ujkhm/micro-generator-test-machine/BOM/Master BOM.XLSX

Reference | Qty | Value | DNP | Exclude from BOM | Exclude from Board | Footprint | Datasheet |  | 價格(人民幣) | 價格(台幣)
C1,C7,C8,C10,C12 | 5 | 1uF |  |  |  | Capacitor_SMD:C_0603_1608Metric | ~ |  | 0.4 | 1.88
C2,C14 | 2 | 22uF |  |  |  | Capacitor_SMD:C_0805_2012Metric | ~ |  | 0.48 | 2.25
C3 | 1 | 150pF |  |  |  | Capacitor_SMD:C_0603_1608Metric | ~ |  | 0.044 | 0.22
C4,C5,C6,C9,C11,C13,C15,C16,C17,C18 | 10 | 0.1uF |  |  |  | Capacitor_SMD:C_0603_1608Metric | ~ |  | 0.5 | 2.35
D1,D3 | 2 | B340 |  |  |  | Diode_SMD:D_SMC | http://www.jameco.com/Jameco/Products/ProdDS/1538777.pdf |  | 0.31 | 1.46
D2 | 1 | SS14 |  |  |  | Diode_SMD:D_SMA | https://www.vishay.com/docs/88746/ss12.pdf |  |  | 1
J1 | 1 | DC-IN |  |  |  | Connector_BarrelJack:BarrelJack_Kycon_KLDX-0202-xC_Horizontal | ~ |  |  | 10
J2 | 1 | TYPE-C |  |  |  | USB4105-GF-A:GCT_USB4105-GF-A |  |  |  | 10
J3,J4,J5,J6 | 4 | Conn_01x03_Pin |  |  |  | Connector_PinHeader_2.54mm:PinHeader_1x03_P2.54mm_Vertical | ~ |  | DNP | DNP
L1 | 1 | 15uH |  |  |  | DC-DC POWER L1:WE-PD_1260 |  |  | 3.55 | 16.62
Q1 | 1 | IRF3708 |  |  |  | IRF3708:TO-220-3_L10.0-W4.6-P2.54-L |  |  | 2.85 | 13.39
R1 | 1 | 210K |  |  |  | Resistor_SMD:R_0603_1608Metric | ~ |  | 0.022 | 0.11
R2 | 1 | 40.2K |  |  |  | Resistor_SMD:R_0603_1608Metric | ~ |  | 0.022 | 0.11
R3 | 1 | 100K |  |  |  | Resistor_SMD:R_0603_1608Metric | ~ |  | 0.022 | 0.11
R4 | 1 | 200K |  |  |  | Resistor_SMD:R_0603_1608Metric | ~ |  | 0.022 | 0.11
R5,R6,R7 | 3 | 5.1K |  |  |  | Resistor_SMD:R_0603_1608Metric | ~ |  | 0.066 | 0.33
R8 | 1 | 0.1R |  |  |  | Resistor_SMD:R_2512_6332Metric | ~ |  | 0.33 | 1.55
R9,R10,R11 | 3 | 10K |  |  |  | Resistor_SMD:R_0603_1608Metric | ~ |  | 0.066 | 0.33
SW1 | 1 | reset |  |  |  | button:SW-TH_4P-L6.0-W6.0-P4.50-LS6.5 | https://lcsc.com/product-detail/Tactile-Switches_SHOU-HAN-TS665CJ_C393938.html |  |  | 2
SW2 | 1 | start |  |  |  | button:SW-TH_4P-L6.0-W6.0-P4.50-LS6.5 | https://lcsc.com/product-detail/Tactile-Switches_SHOU-HAN-TS665CJ_C393938.html |  |  | 2
U1 | 1 | ESP32-WROOM-32E |  |  |  | RF_Module:ESP32-WROOM-32D | https://www.espressif.com/sites/default/files/documentation/esp32-wroom-32e_esp32-wroom-32ue_datasheet_en.pdf |  | 17.3 | 83
U2 | 1 | MP1584EN |  |  |  | MP1584:SOIC127P600X170-9N |  |  |  | 33
U3 | 1 | CH340C |  |  |  | Package_SO:SOIC-16_3.9x9.9mm_P1.27mm | https://datasheet.lcsc.com/szlcsc/Jiangsu-Qin-Heng-CH340C_C84681.pdf |  | 2.31 | 10.83
U4 | 1 | RT9013-33GB |  |  |  | RT9013-33GB:SOT94P279X129-5N |  |  | 0.48 | 2.25
U5 | 1 | DM-OLED096-636 |  |  |  | OLED:MODULE_DM-OLED096-636 |  |  |  | 70
U6 | 1 | INA232AIDDFR |  |  |  | INA232AIDDFR:SOT65P280X110-8N |  |  | 11 | 51.49
U7 | 1 | MIC4420YM |  |  |  | MIC4420YM:SOIC-8_L4.9-W3.9-P1.27-LS6.0-BL |  |  | 2.99 | 14.05
U8 | 1 | LM358 |  |  |  | Package_SO:SOIC-8_5.3x6.2mm_P1.27mm | http://www.ti.com/lit/ds/symlink/lm2904-n.pdf |  | 0.29 | 1.36
平台運費+手續費 |  |  |  |  |  |  |  |  |  | 56.86
以上為PCB實際用料(與同路徑下的KiCad.xlsx相同)，以下為PCB外之用料
 |  |  |  | 用量 |  | 價格(人民幣) |  | 價格(台幣)
24V 775高速馬達 |  |  |  | 1 |  | 19.5 |  | 94
對射光電傳感器模組 |  |  |  | 1 |  | 2.8 |  | 13
10歐負載電阻 |  |  |  | 3 |  | 1.485 |  | 6.96
繼電器 |  |  |  | 1 |  |  |  | 15
sSS54 |  |  |  | 1 |  |  |  | 2
聯軸器 |  |  |  | 10 |  |  |  | 180
總價 |  |  |  |  |  |  |  | 699.62
