ujkhm/micro-generator-test-machine/3D_print_Component/ESP32_MPPT.FCStd

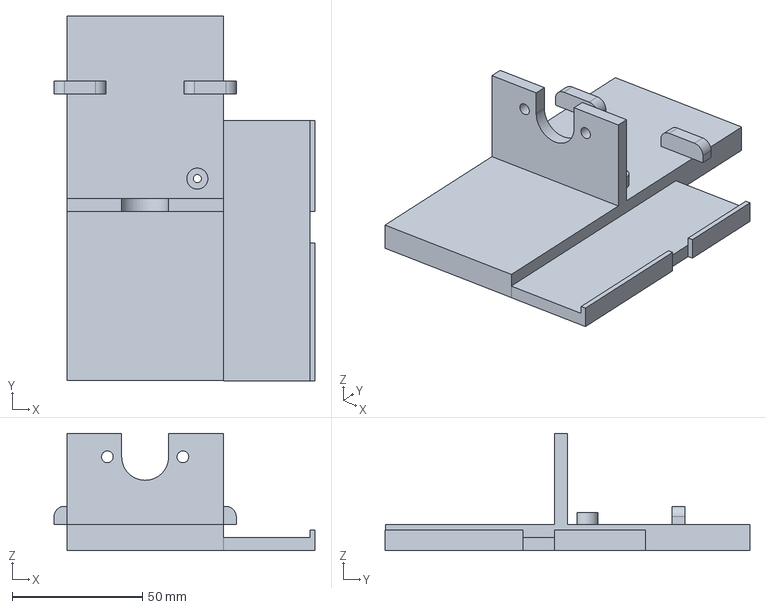
[picture p1: CAD file, 2026-10-07]
3D_print_Component/ESP32_MPPT.FCStd
100.2 x 140.1 x 45.0 mm
