ujkhm/micro-generator-test-machine/(list of files, cad)

Other CAD files:
3D_print_Component/ESP32_MPPT_TEST-主體.stl
