ujkhm/micro-generator-test-machine/KiCad/KiCad.kicad_sch

## KiCad design KiCad/KiCad.kicad_sch (2026-10-07)

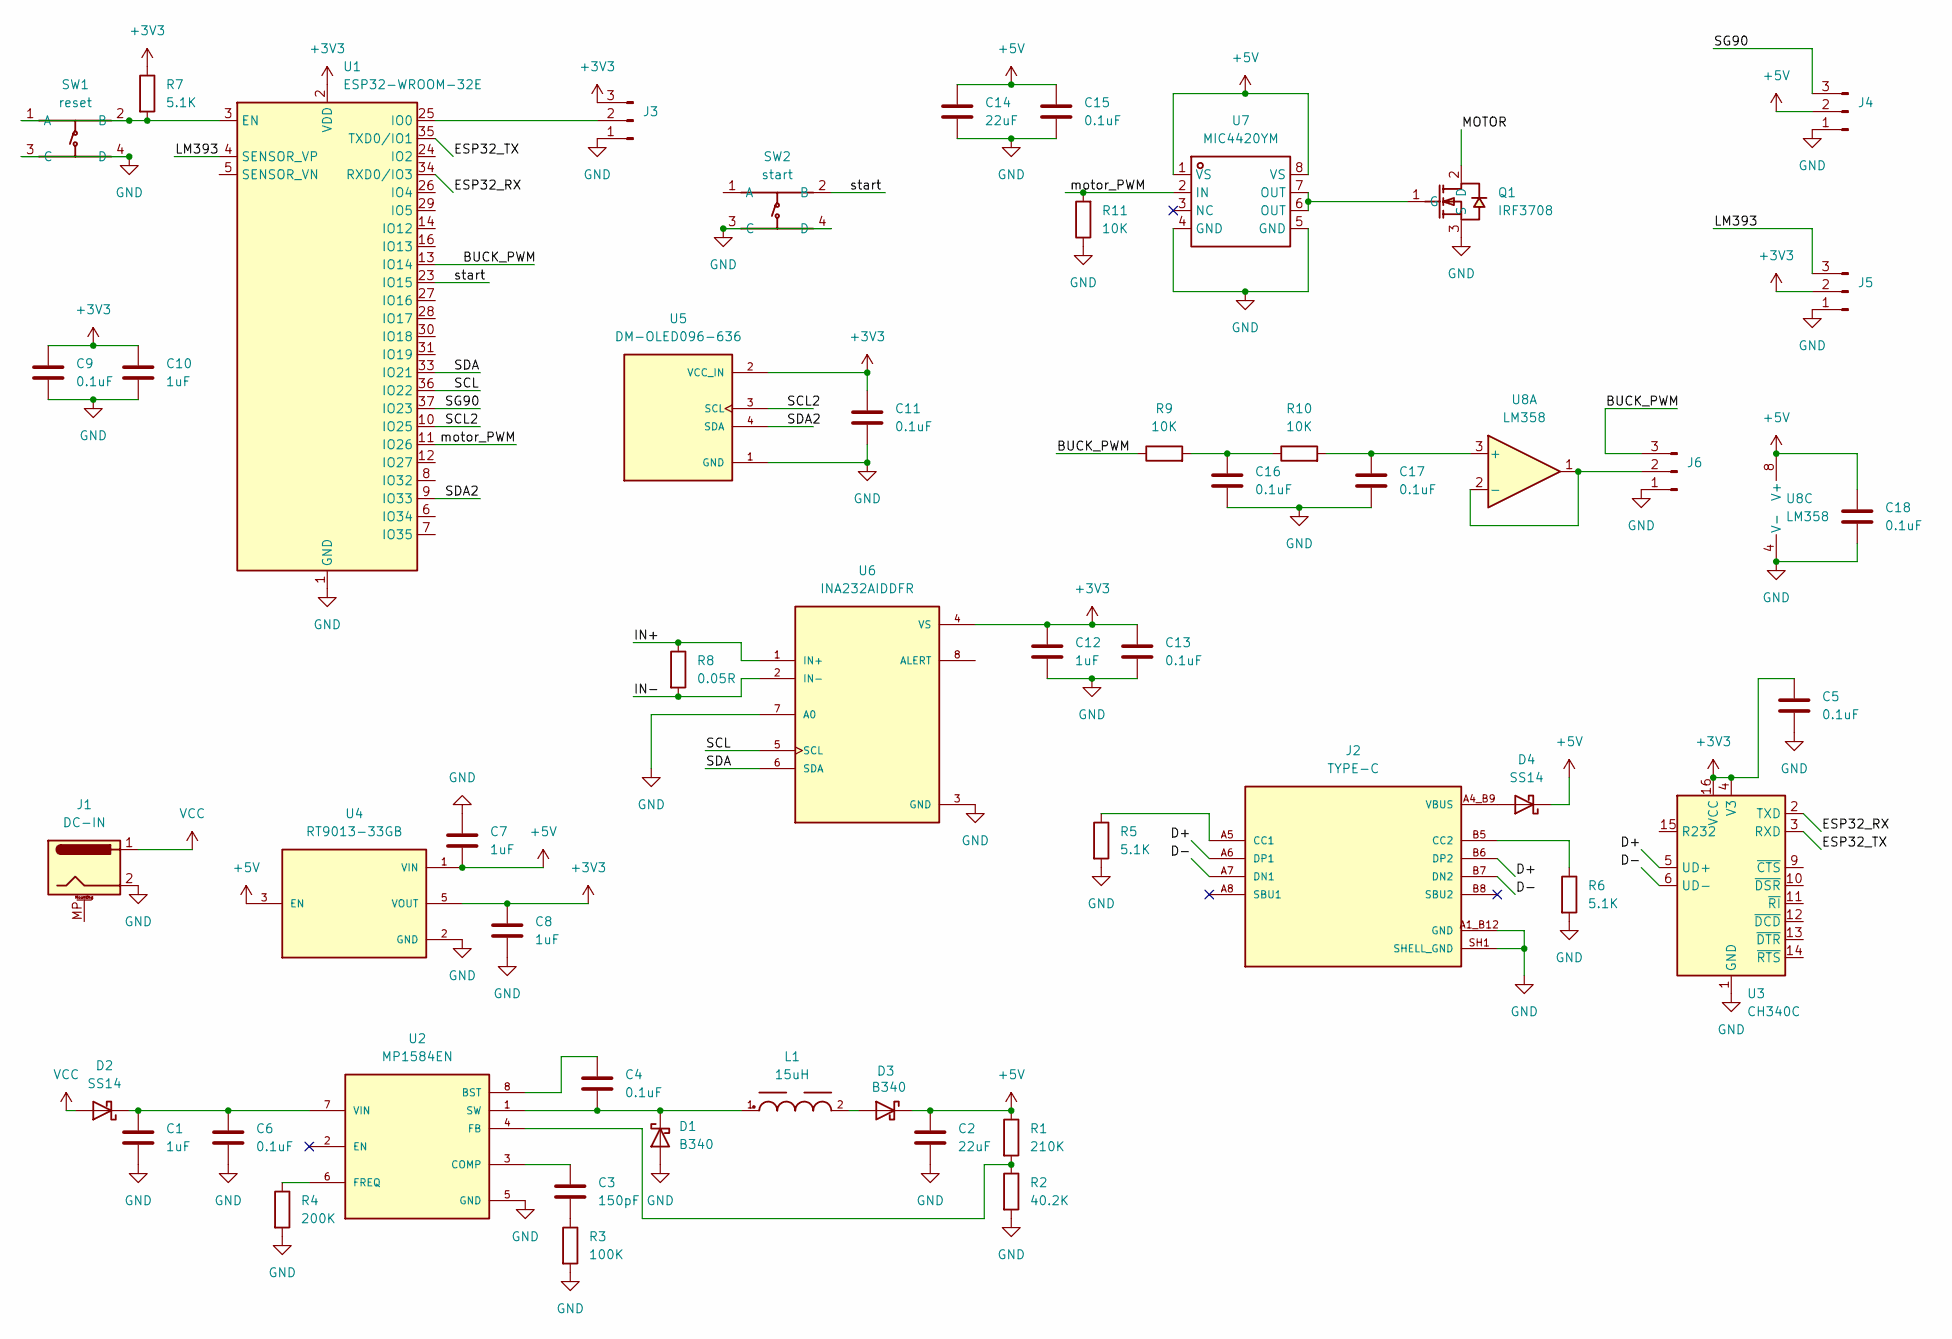
[picture p2: schematic KiCad.kicad_sch]

Parts:
C1, C7, C8, C10, C12: 1uF; C_0603_1608Metric
C2, C14: 22uF; C_0805_2012Metric
C3: 150pF; C_0603_1608Metric
C4, C5, C6, C9, C11, C13, C15, C16, C17, C18: 0.1uF; C_0603_1608Metric
D1, D3: B340; D_SMC
D2, D4: SS14; D_SMA
J1: DC-IN; BarrelJack_Kycon_KLDX-0202-xC_Horizontal
J2: TYPE-C; GCT_USB4105-GF-A; PARTREV B4
J3, J4, J5, J6: Conn_01x03_Pin; PinHeader_1x03_P2.54mm_Vertical
L1: 15uH; WE-PD_1260
Q1: IRF3708; TO-220-3_L10.0-W4.6-P2.54-L; LCSC Part C18212457
R1: 210K; R_0603_1608Metric
R2: 40.2K; R_0603_1608Metric
R3: 100K; R_0603_1608Metric
R4: 200K; R_0603_1608Metric
R5, R6, R7: 5.1K; R_0603_1608Metric
R8: 0.05R; R_2512_6332Metric
R9, R10, R11: 10K; R_0603_1608Metric
SW1: reset; SW-TH_4P-L6.0-W6.0-P4.50-LS6.5; LCSC Part C393938
SW2: start; SW-TH_4P-L6.0-W6.0-P4.50-LS6.5; LCSC Part C393938
U1: ESP32-WROOM-32E; ESP32-WROOM-32D
U2: MP1584EN; SOIC127P600X170-9N
U3: CH340C; SOIC-16_3.9x9.9mm_P1.27mm
U4: RT9013-33GB; SOT94P279X129-5N; PARTREV Aprill 2011
U5: DM-OLED096-636; MODULE_DM-OLED096-636; PARTREV 2018-09-10
U6: INA232AIDDFR; SOT65P280X110-8N; PARTREV December 2022
U7: MIC4420YM; SOIC-8_L4.9-W3.9-P1.27-LS6.0-BL; LCSC Part C637530
U8: LM358; SOIC-8_5.3x6.2mm_P1.27mm

Connections:
+3V3: C5.1, C8.1, C9.1, C10.1, C11.1, C12.1, C13.1, J3.3, J5.2, R7.1, U1.2 (VDD), U3.4 (V3), U3.16 (VCC), U4.5 (VOUT), U5.2 (VCC_IN), U6.4 (VS)
+5V: C2.1, C7.2, C14.1, C15.1, C18.1, D3.1 (K), D4.1 (K), J4.2, R1.1, U4.1 (VIN), U4.3 (EN), U7.1 (VS), U7.8 (VS), U8.8 (V+)
BUCK_PWM: J6.3, R9.1, U1.13 (IO14)
GND: C1.2, C2.2, C5.2, C6.2, C7.1, C8.2, C9.2, C10.2, C11.2, C12.2, C13.2, C14.2, C15.2, C16.2, C17.2, C18.2, D1.2 (A), J1.2, J2.A1_B12 (GND), J2.B1_A12 (GND), J2.SH1 (SHELL_GND), J2.SH2 (SHELL_GND), J2.SH3 (SHELL_GND), J2.SH4 (SHELL_GND), J3.1, J4.1, J5.1, J6.1, Q1.3 (S), R2.2, R3.2, R4.2, R5.2, R6.2, R11.1, SW1.3 (C), SW1.4 (D), SW2.3 (C), SW2.4 (D), U1.1 (GND), U1.15 (GND), U1.38 (GND), U1.39 (GND), U2.5 (GND), U2.9 (GND), U3.1 (GND), U4.2 (GND), U5.1 (GND), U6.3 (GND), U6.7 (A0), U7.4 (GND), U7.5 (GND), U8.4 (V-)
IN+: R8.1, U6.1 (IN+)
IN-: R8.2, U6.2 (IN-)
LM393: J5.3, U1.4 (SENSOR_VP)
MOTOR: Q1.2 (D)
unnamed: C1.1, C6.1, D2.1 (K), U2.7 (VIN)
unnamed: C3.1, U2.3 (COMP)
unnamed: C3.2, R3.1
unnamed: C4.1, U2.8 (BST)
unnamed: C4.2, D1.1 (K), L1.1, U2.1 (SW)
unnamed: C16.1, R9.2, R10.1
unnamed: C17.1, R10.2, U8.3 (+)
unnamed: D3.2 (A), L1.2
unnamed: D4.2 (A), J2.A4_B9 (VBUS), J2.B4_A9 (VBUS)
unnamed: J2.A5 (CC1), R5.1
unnamed: J2.B5 (CC2), R6.1
unnamed: J3.2, U1.25 (IO0)
unnamed: J6.2, U8.1, U8.2 (-)
unnamed: Q1.1 (G), U7.6 (OUT), U7.7 (OUT)
unnamed: R1.2, R2.1, U2.4 (FB)
unnamed: R4.1, U2.6 (FREQ)
unnamed: R7.2, SW1.1 (A), SW1.2 (B), U1.3 (EN)
SCL: U1.36 (IO22), U6.5 (SCL)
SCL2: U1.10 (IO25), U5.3 (SCL)
SDA: U1.33 (IO21), U6.6 (SDA)
SDA2: U1.9 (IO33), U5.4 (SDA)
SG90: J4.3, U1.37 (IO23)
VCC: D2.2 (A), J1.1
motor_PWM: R11.2, U1.11 (IO26), U7.2 (IN)
start: SW2.2 (B), U1.23 (IO15)
