ujkhm/micro-generator-test-machine/VSCode/esp32_code/src/bt_telemetry/bt_telemetry.h

#pragma once

#include <Arduino.h>
#include "settings/settings.h"
#include "RTOS/RTOS.h"

// 藍牙序列遙測：用 BluetoothSerial(傳統 SPP，Windows 端配對後會出現一個虛擬 COM 埠，
// 上位機可直接用既有的序列埠邏輯開啟)，單向推播 JSON 快照，讓上位機能讀到
// settings.h 內所有跟顯示/報表相關的數據。另接受一行指令 RISE <溫升°C>，
// 作為安全電流的停測溫升；以及 OTA <位元組數> <版本> <sha256>，由上位機經這條
// 藍牙序列埠寫入另一個程式區。起動測試仍是板上 START 鈕。
//
// 訊息格式(換行分隔)：
//   {"t":"live", ...} 每約 200ms 送一次：所有「即時會變」的欄位
//   {"t":"curve", "n":<count>, "pts":[[rpm,v,p,r_opt], ...]} 曲線算完後每約 3 秒重送一次整張表，
//   讓中途才連上或重新連上的上位機也能拿到完整結果(推播式協定沒有「上位機主動查詢」這個管道)。
//   不是 JSON 的一行是 Serial 除錯鏡射（與 USB 監控相同的文字）。上位機另存 log，不當測試數據。
void bt_telemetry_start();
