ujkhm/micro-generator-test-machine/(commit log)

2026-09-20 新增完整BOM
    [Master BOM.XLSX]
2026-10-07 改以線圈溫升判斷安全電流，並讓上位機指定停測溫升。
    分流改為 0.05 歐姆、測試負載 3 歐姆；電流碰到上限改走上一通過檔。同步整理機殼模型。
    [1_0-1.stl, 1_0-M.stl, 1_1.stl, 1_2.stl, 1_3.stl, 1_4.stl, 1_5.stl, ESP32_MPPT-主體.stl]
2026-10-07 安全電流結束時沿用空載 PWM 交接，避免高轉從零重拉而爆衝。
2026-10-07 更新已重新打包的上位機，包含溫升上限輸入與不再閃爍的等待畫面。
2026-10-09 加入藍牙 OTA：上位機比對較新韌體後經現有連線寫入，並避免未連線時開啟序列埠卡住視窗。
